philmcm/tbc_ui/3dmodels/TL1100F160Q--3DModel-STEP-613395.STEP

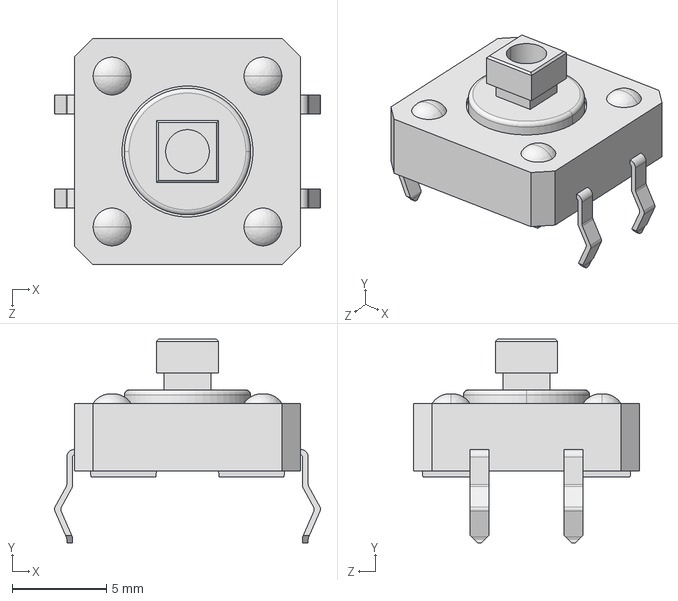
[picture p1: CAD file, 2024-02-24]
3dmodels/TL1100F160Q--3DModel-STEP-613395.STEP
14.1 x 10.8 x 12.0 mm
