philmcm/tbc_ui/3dmodels/424.STEP

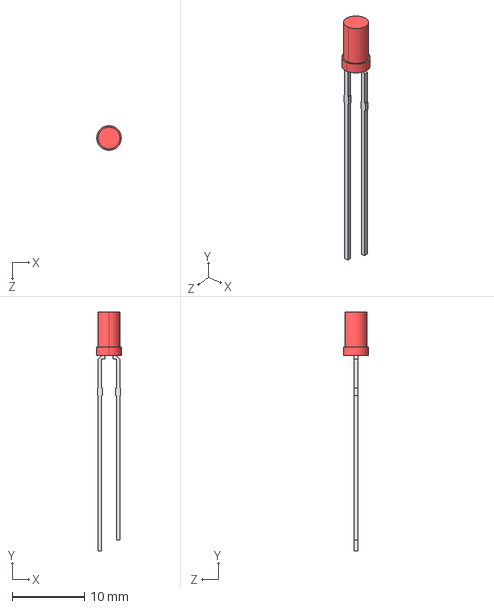
[picture p2: CAD file, 2024-02-23]
3dmodels/424.STEP
3.40 x 33.0 x 3.40 mm
