philmcm/tbc_ui/3dmodels/ICM7555CBAZ.stp

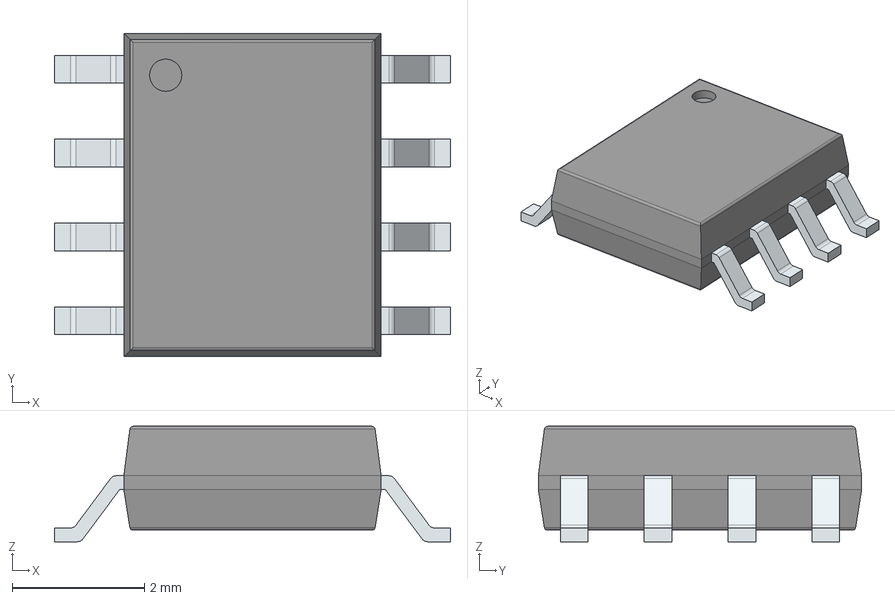
[picture p3: CAD file, 2024-02-23]
3dmodels/ICM7555CBAZ.stp
6.00 x 4.90 x 1.75 mm
PinsArrayLR
