philmcm/tbc_ui/3dmodels/C0603x0.8mm.STEP

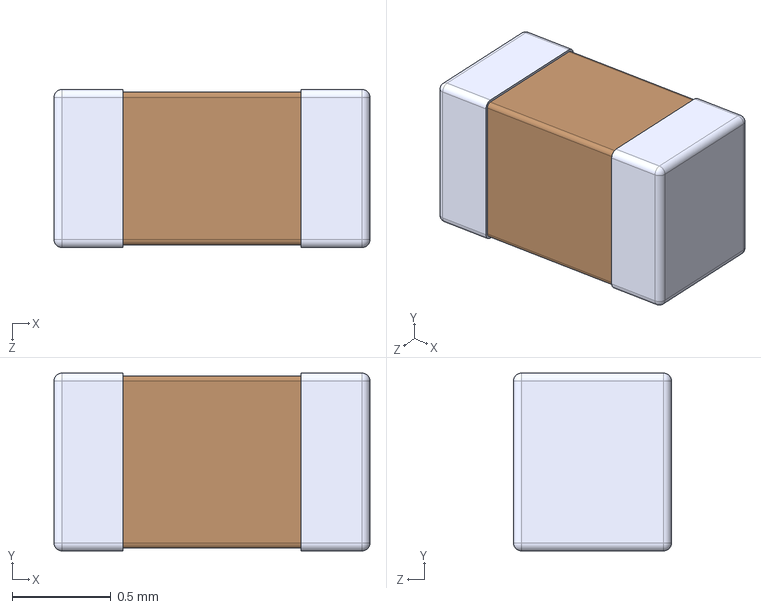
[picture p4: CAD file, 2024-02-22]
3dmodels/C0603x0.8mm.STEP
1.60 x 0.9 x 0.8 mm
