philmcm/tbc_ui/3dmodels/1N4148WS.stp

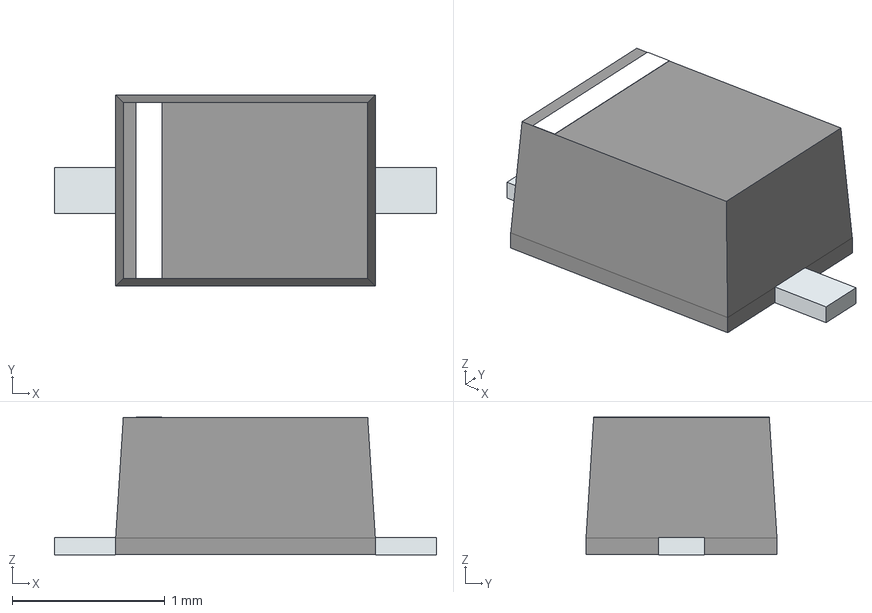
[picture p5: CAD file, 2024-02-22]
3dmodels/1N4148WS.stp
2.50 x 1.25 x 0.9 mm
PinKIdent
PinK
PinA
