philmcm/tbc_ui/3dmodels/NHD-0420CW.STEP

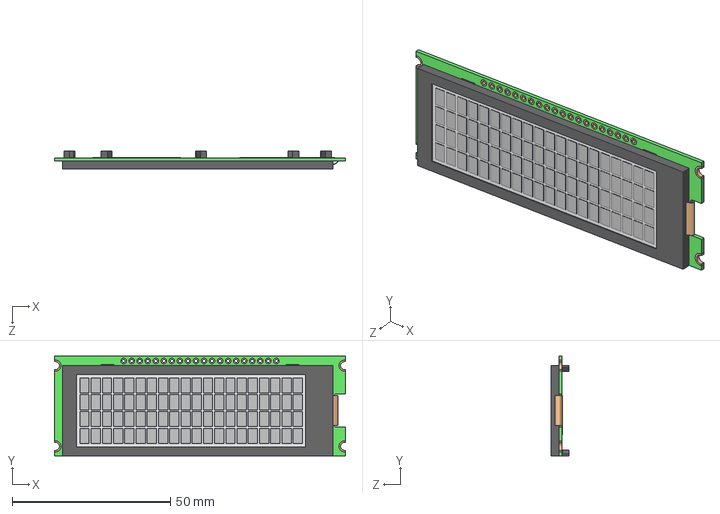
[picture p6: CAD file, 2024-02-22]
3dmodels/NHD-0420CW.STEP
92.0 x 31.5 x 5.60 mm
