philmcm/tbc_ui/3dmodels/PEC11R-4220F-S0024.stp

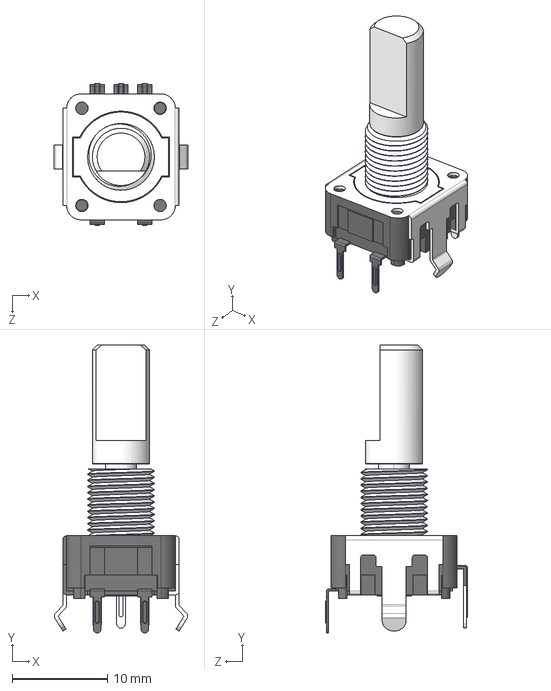
[picture p7: CAD file, 2024-02-22]
3dmodels/PEC11R-4220F-S0024.stp
14.0 x 30.2 x 14.9 mm
