philmcm/tbc_ui/3dmodels/R0603.step

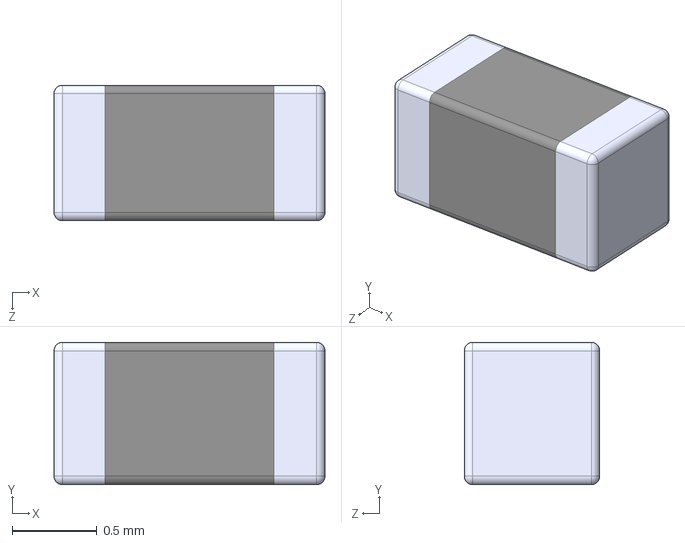
[picture p9: CAD file, 2024-02-22]
3dmodels/R0603.step
1.60 x 0.84 x 0.8 mm
