philmcm/tbc_ui/3dmodels/75869-105LF--3DModel-STEP-56544.STEP

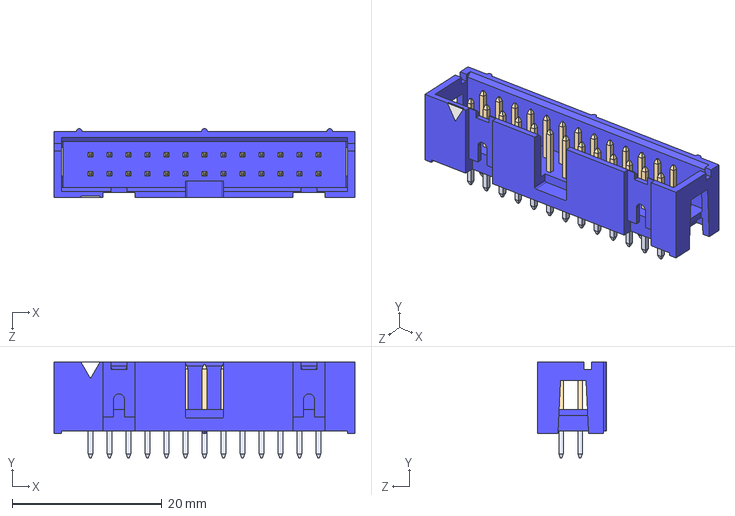
[picture p10: CAD file, 2024-02-22]
3dmodels/75869-105LF--3DModel-STEP-56544.STEP
40.2 x 12.8 x 9.20 mm
