philmcm/tbc_ui/tbc_ui.pdf

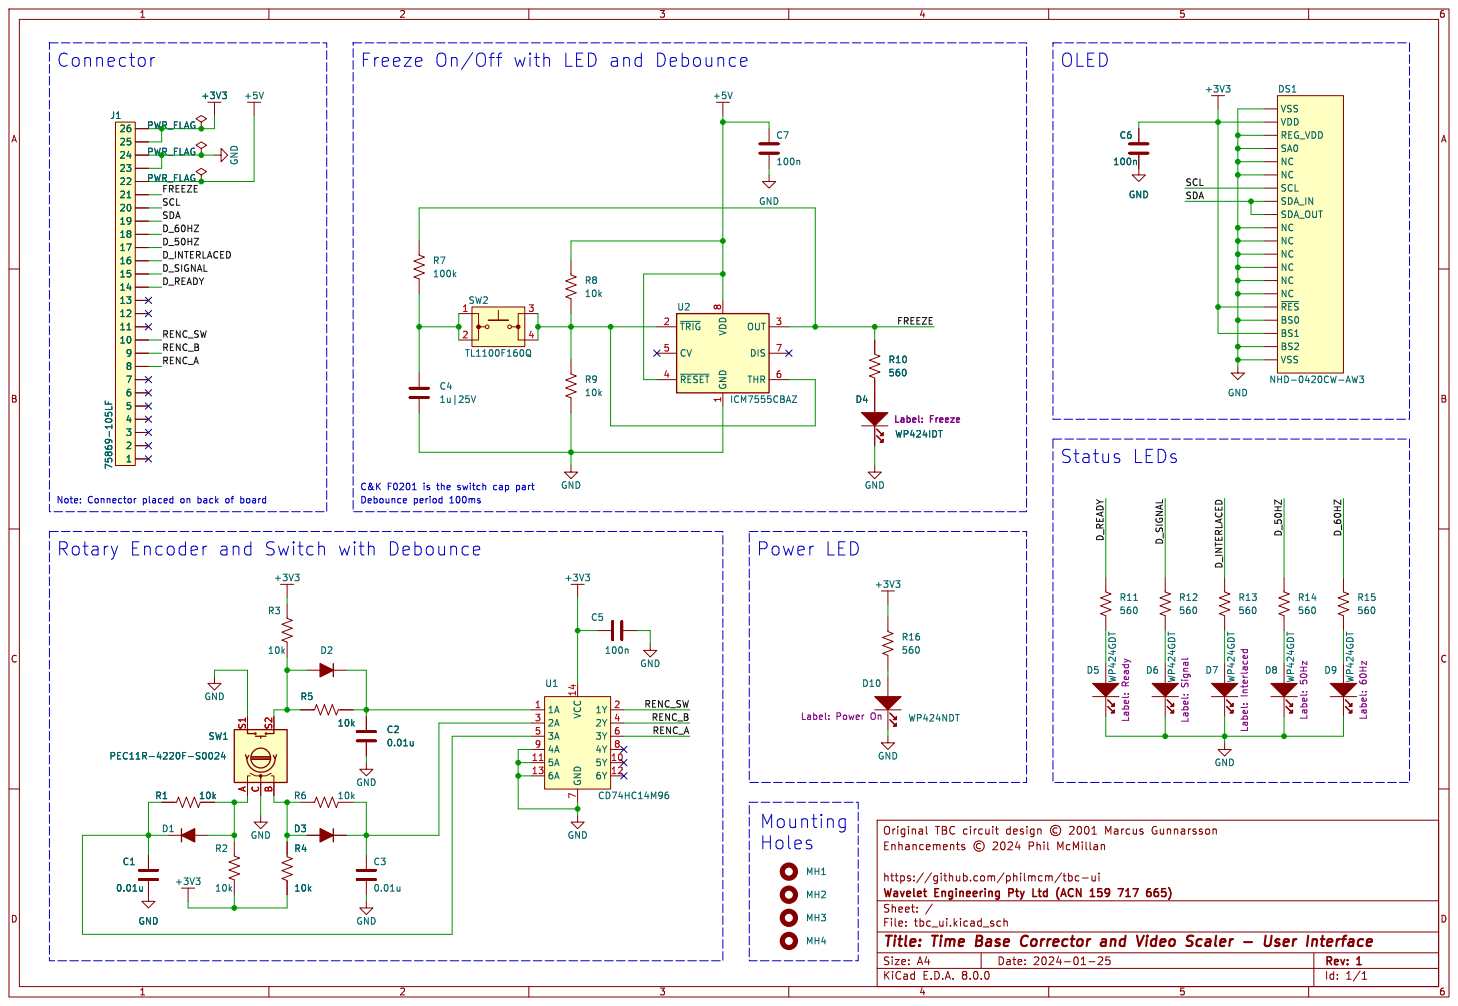
[picture p11: page 1]

Freeze On/Off with LED and Debounce

8 ~{TRIG} 2 OUT 3 ~{RESET} 4 CV 5 THR 6 DIS 7 U2

Rotary Encoder and Switch with Debounce

Id: 1/1 Title: Time Base Corrector and Video Scaler - User Interface
