philmcm/tbc_ui/tbc_ui.kicad_pcb

## KiCad design tbc_ui.kicad_pcb (2025-01-18)

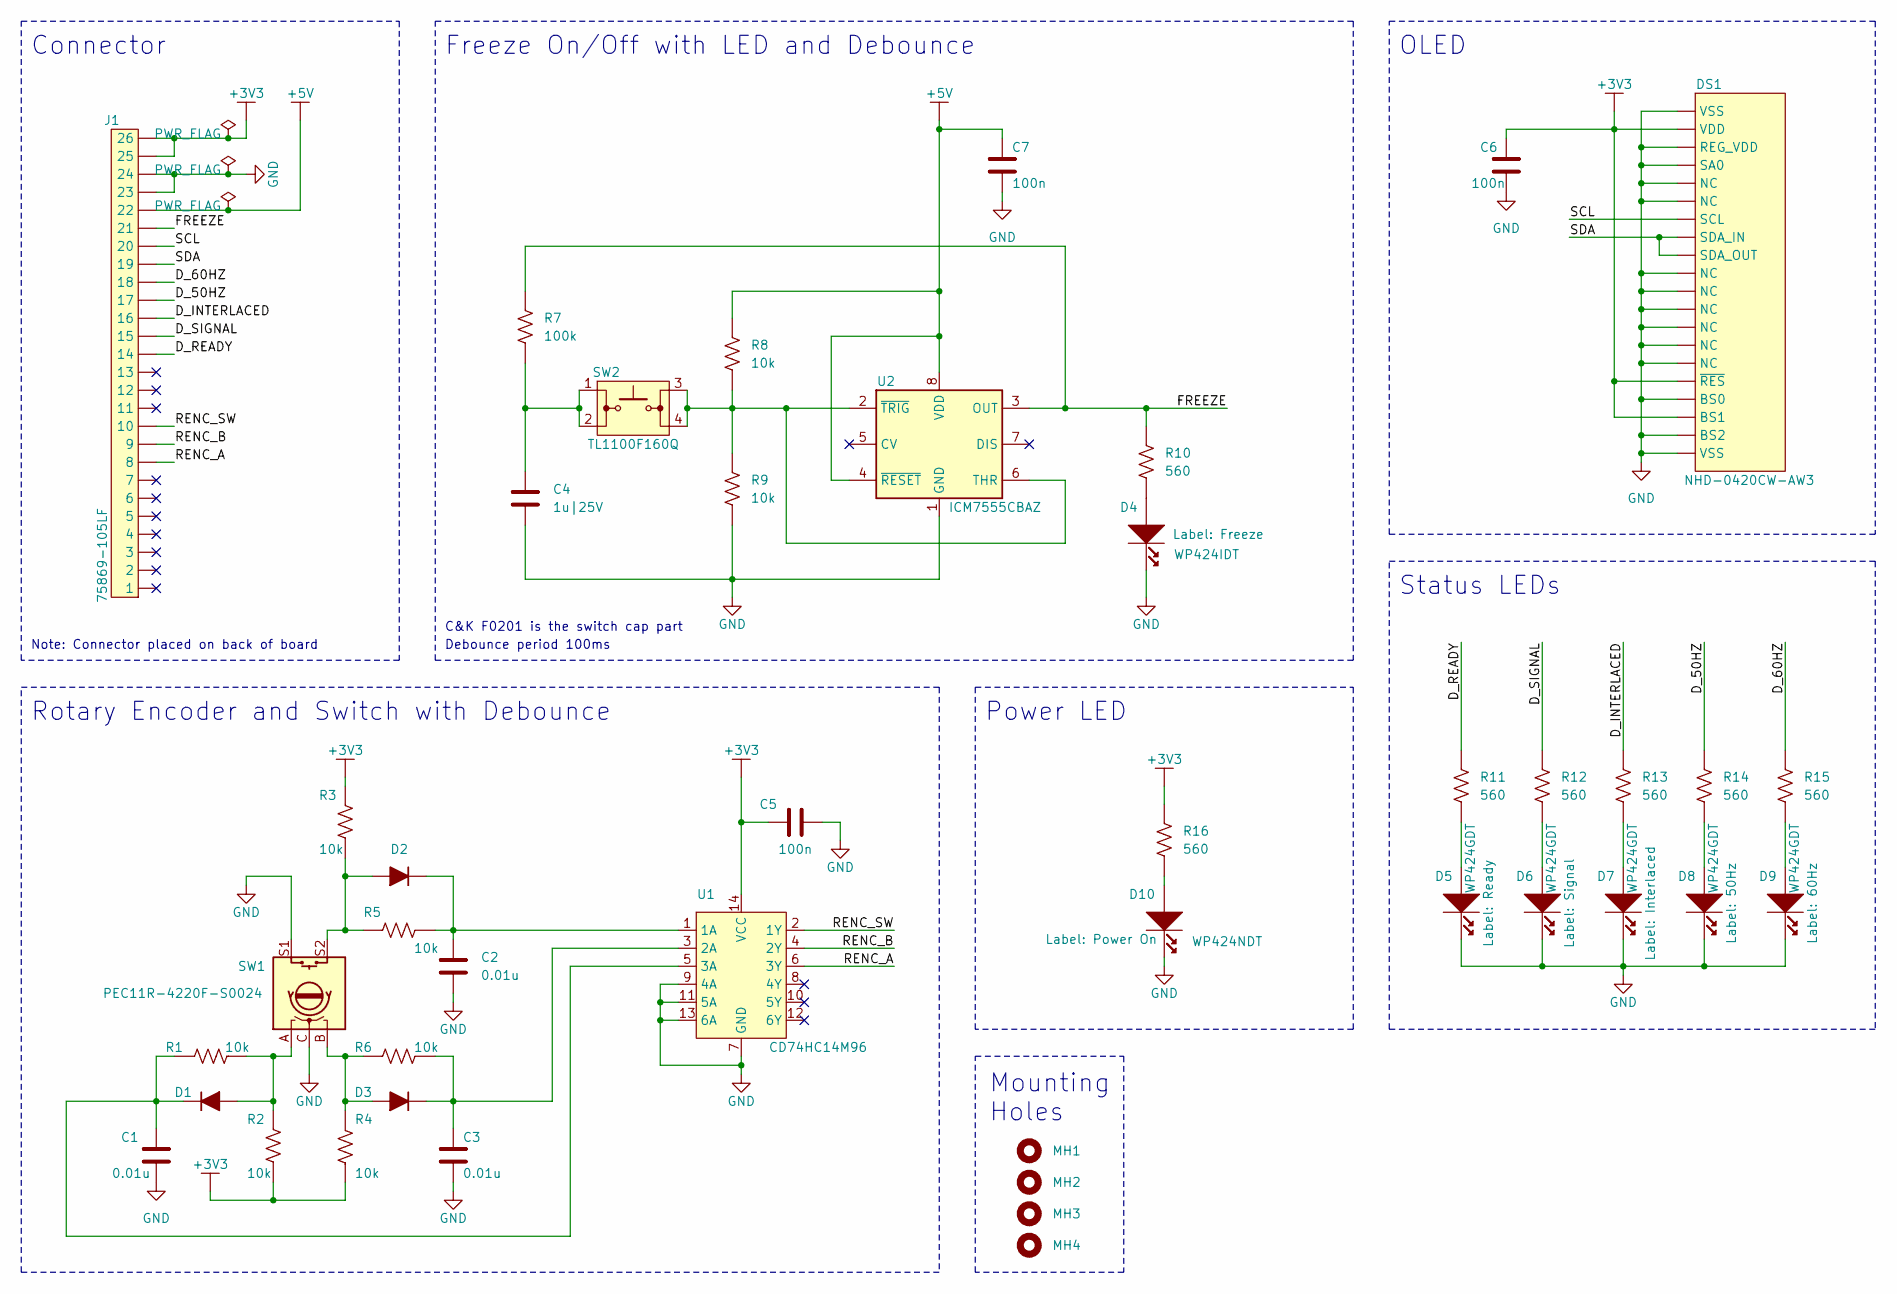
[picture p12: schematic tbc_ui.kicad_sch, Time Base Corrector and Video Scaler - User Interface]

Parts:
C1, C2, C3: 0.01u; C0603; Mouser 81-GCM188R71H103KA7J
C4: 1u|25V; C0603; Mouser 81-GCJ188R71E105KA1D
C5, C6, C7: 100n; C0603; Mouser 81-GCJ188R71H104KA2D
D1, D2, D3: 1N4148WS; Mouser 512-1N4148WS
D4: WP424IDT; WP424; Mouser 604-WP424IDT
D5, D6, D7, D8, D9: WP424GDT; WP424; Mouser 604-WP424GDT
D10: WP424NDT; WP424; Mouser 604-WP424NDT
DS1: NHD-0420CW-AW3; NHD-0420CW; Mouser 763-NHD-0420CW-AW3
J1: 75869-105LF; Mouser 649-75869-105LF
MH1, MH2, MH3, MH4: MH_7.4MMNCx3.2MMD; MH_7.4MMCx3.2MMD_NON_COPPER_NPTH
R1, R2, R3, R4, R5, R6, R8, R9: 10k; R0603; Mouser 603-RC0603FR-0710KL
R7: 100k; R0603; Mouser 603-RC0603FR-07100KL
R10, R11, R12, R13, R14, R15, R16: 560; R0603; Mouser 603-RC0603FR-07560RL
SW1: PEC11R-4220F-S0024; PEC11R-4xxxF-Sxxx; Mouser 652-PEC11R-4220F-S24
SW2: TL1100F160Q; TL1100F; Mouser 612-TL1100
U1: CD74HC14M96; SOIC-14; Mouser 595-CD74HC14M96
U2: ICM7555CBAZ; SOIC-8; Mouser 968-ICM7555CBAZ

Connections:
+3V3: C5.1, C6.2, DS1.2 (VDD), DS1.16 (~RES), DS1.18 (BS1), J1.25, J1.26, R2.1, R3.2, R4.2, R16.2, U1.14 (VCC)
+5V: C7.2, J1.22, R8.2, U2.4 (~RESET), U2.8 (VDD)
/D_50HZ: J1.17, R14.2
/D_60HZ: J1.18, R15.2
/D_INTERLACED: J1.16, R13.2
/D_READY: J1.14, R11.2
/D_SIGNAL: J1.15, R12.2
/FREEZE: J1.21, R7.2, R10.2, U2.3 (OUT)
/RENC_A: J1.8, U1.6 (3Y)
/RENC_B: J1.9, U1.4 (2Y)
/RENC_SW: J1.10, U1.2 (1Y)
/SCL: DS1.7 (SCL), J1.20
/SDA: DS1.8 (SDA_IN), DS1.9 (SDA_OUT), J1.19
GND: C1.1, C2.1, C3.1, C4.1, C5.2, C6.1, C7.1, D4.1 (Cathode), D5.1 (Cathode), D6.1 (Cathode), D7.1 (Cathode), D8.1 (Cathode), D9.1 (Cathode), D10.1 (Cathode), DS1.1 (VSS), DS1.3 (REG_VDD), DS1.4 (SA0), DS1.5 (NC), DS1.6 (NC), DS1.10 (NC), DS1.11 (NC), DS1.12 (NC), DS1.13 (NC), DS1.14 (NC), DS1.15 (NC), DS1.17 (BS0), DS1.19 (BS2), DS1.20 (VSS), J1.23, J1.24, R9.1, SW1.C, SW1.S1, U1.7 (GND), U1.9 (4A), U1.11 (5A), U1.13 (6A), U2.1 (GND)
unnamed: C4.2, R7.1, SW2.1, SW2.2
unnamed: D1.2 (A), R1.2, R2.2, SW1.A
unnamed: C1.2, D1.1 (K), R1.1, U1.5 (3A)
unnamed: D2.2 (A), R3.1, R5.2, SW1.S2
unnamed: C2.2, D2.1 (K), R5.1, U1.1 (1A)
unnamed: D3.2 (A), R4.1, R6.2, SW1.B
unnamed: C3.2, D3.1 (K), R6.1, U1.3 (2A)
unnamed: D4.2 (Anode), R10.1
unnamed: D5.2 (Anode), R11.1
unnamed: D6.2 (Anode), R12.1
unnamed: D7.2 (Anode), R13.1
unnamed: D8.2 (Anode), R14.1
unnamed: D9.2 (Anode), R15.1
unnamed: D10.2 (Anode), R16.1
unnamed: R8.1, R9.2, SW2.3, SW2.4, U2.2 (~TRIG), U2.6 (THR)

Notes on the sheet:
Mounting Holes
Connector
OLED
Debounce period 100ms
Freeze On/Off with LED and Debounce
Power LED
Status LEDs
Rotary Encoder and Switch with Debounce
C&K F0201 is the switch cap part
Note: Connector placed on back of board

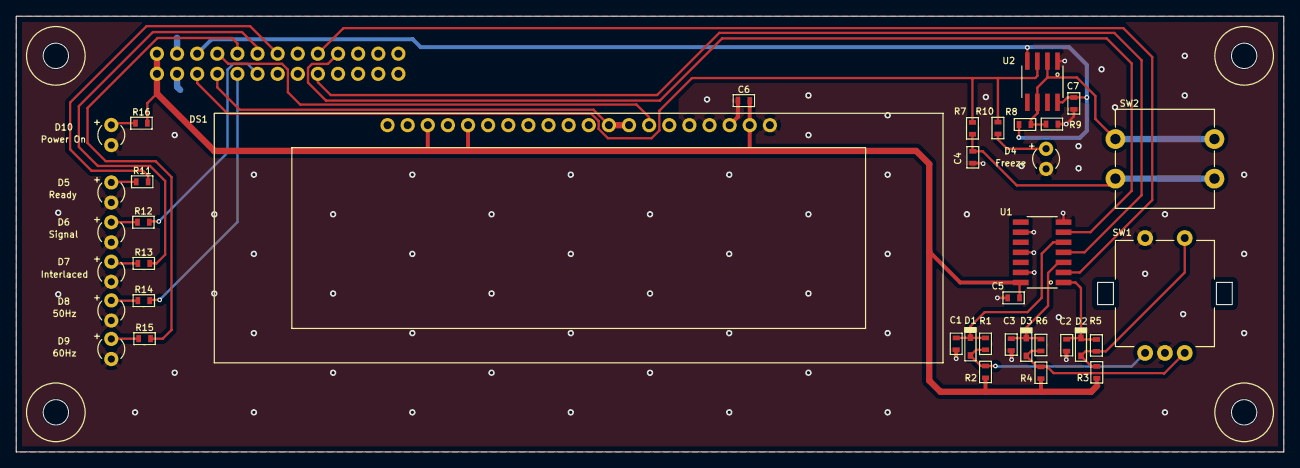
[picture p13: board tbc_ui.kicad_pcb from above]

Board: 2 copper layers, 160.0 x 55.0 mm, 43 parts (1 on the bottom side), 29 nets.
