philmcm/tbc_ui/(commit log)

2024-01-25 annotated and DRC'd schematic
    [tbc_ui.kicad_sch]
2024-01-25 switched out tactile switch
    [tbc_ui.kicad_sch]
2024-01-25 updated IDC symbol
    [tbc_ui.kicad_sch]
2024-01-25 changed 555 to 5V
    [tbc_ui.kicad_sch]
2024-01-27 pull in symbols after simulation model disabled, re-run ERC
    [tbc_ui.kicad_sch]
2024-02-22 initial board layout
    [1N4148WS.stp, 75869-105LF--3DModel-STEP-56544.STEP, C0603x0.8mm.STEP, D0014A.stp, NHD-0420CW.STEP, PEC11R-4220F-S0024.stp, R0603.step, tbc_ui.kicad_pcb]
2024-02-23 additional footprints and layout
    [424.STEP, ICM7555CBAZ.stp, tbc_ui.kicad_pcb, tbc_ui.kicad_sch]
2024-02-24 updated to Kicad 8, finished footprints and layouts, erc passed
    [TL1100F160Q--3DModel-STEP-613395.STEP, tbc_ui.kicad_pcb, tbc_ui.kicad_sch]
2024-02-24 added gerbers and drills
    [tbc_ui-B_Cu.gbl, tbc_ui-B_Mask.gbs, tbc_ui-B_Paste.gbp, tbc_ui-B_Silkscreen.gbo, tbc_ui-Edge_Cuts.gm1, tbc_ui-F_Cu.gtl, tbc_ui-F_Mask.gts, tbc_ui-F_Paste.gtp]
2024-07-08 new copper pours
    [tbc_ui.kicad_pcb]
2025-01-18 upgraded Kicad 8.0.8; .gitignore
2025-01-18 Ran DRC, zero errors
    [tbc_ui.kicad_pcb]
