philmcm/tbc_ui/(notices)

Notices in the files:
tbc_ui.kicad_sch:
Enhancements © 2024 Phil McMillan
Original TBC circuit design © 2001 Marcus Gunnarsson
